HungPham-VNU/game-console/docs/es3n28p/ES3N28P_Size.png

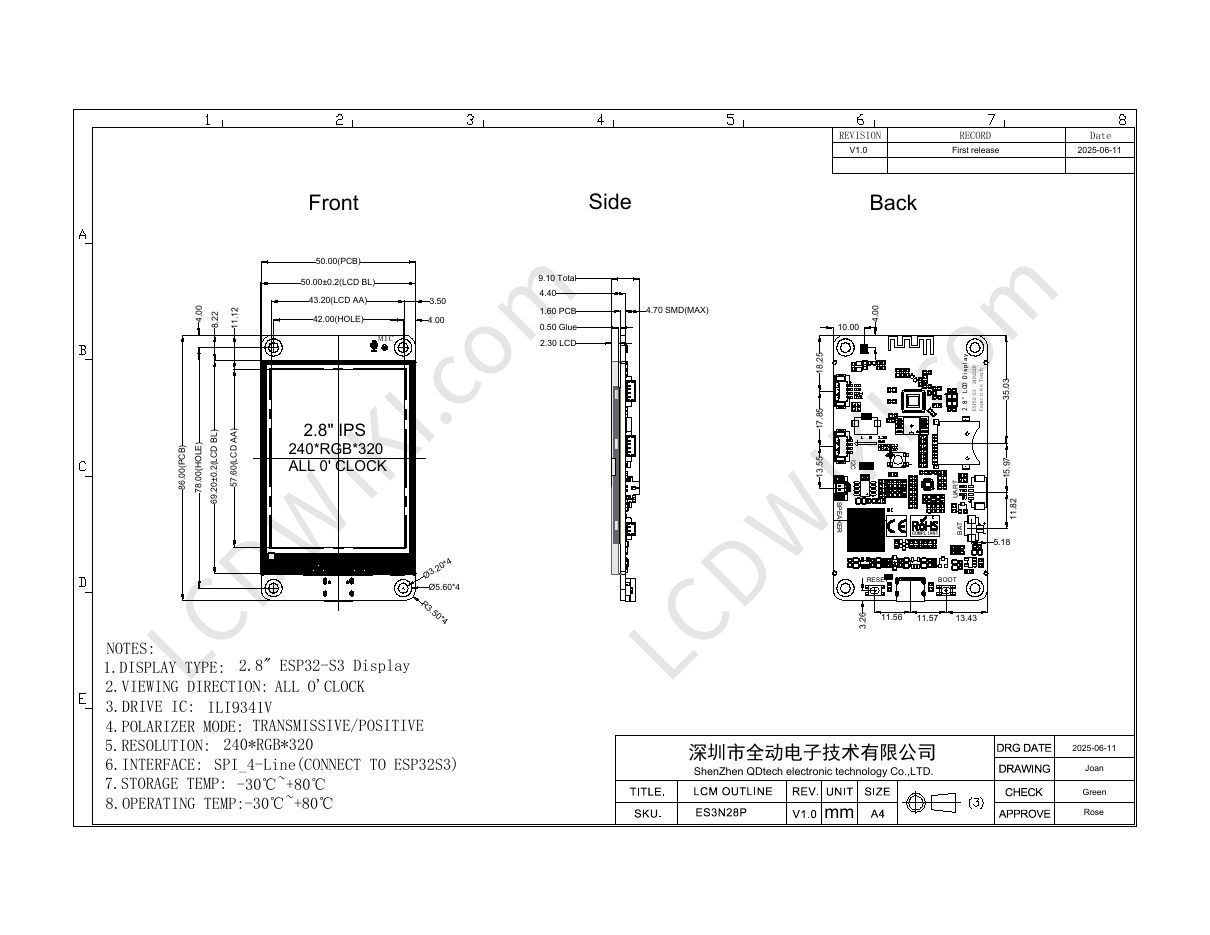
docs/es3n28p/ES3N28P_Size.png
