HungPham-VNU/game-console/enclosure/preview/inside.png

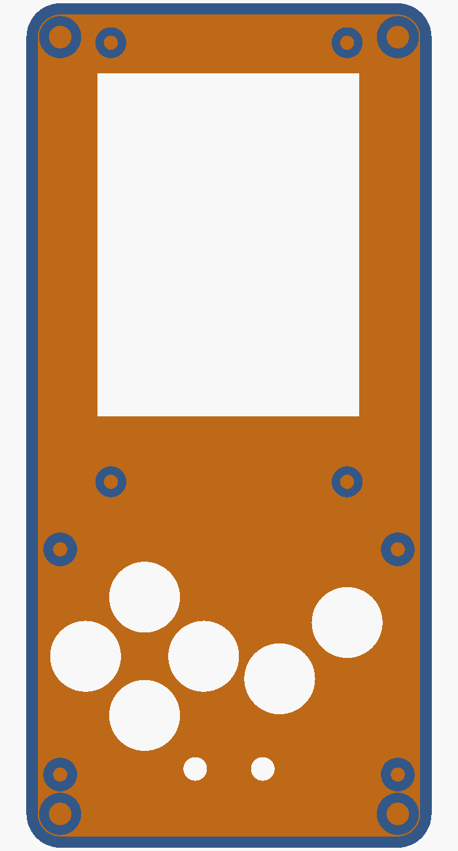
enclosure/preview/inside.png
