HungPham-VNU/game-console/firmware/retro-go-gmt024-s3/assets/retro-go-preview.jpg

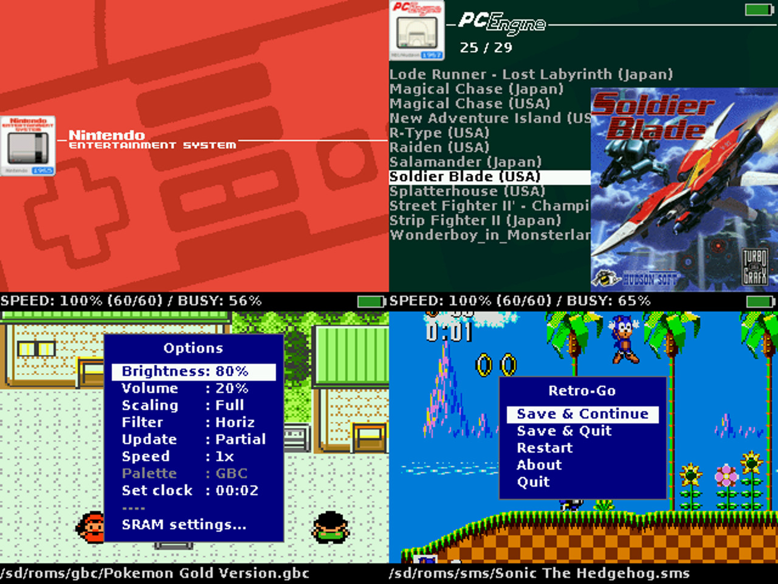
firmware/retro-go-gmt024-s3/assets/retro-go-preview.jpg
