HungPham-VNU/game-console/firmware/retro-go-gmt024-s3/components/retro-go/targets/nullnano/docs/Schematic.png

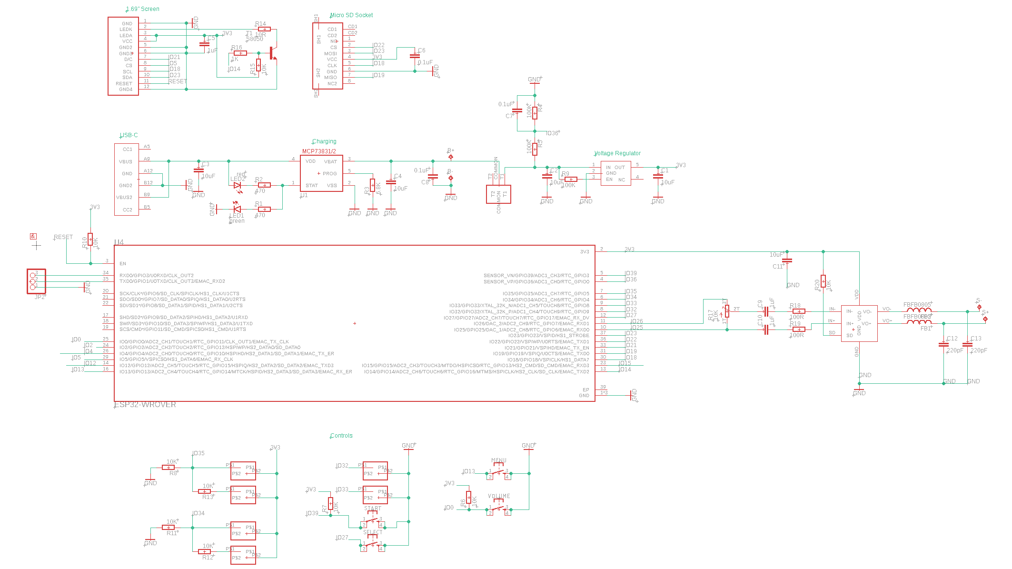
firmware/retro-go-gmt024-s3/components/retro-go/targets/nullnano/docs/Schematic.png
