HungPham-VNU/game-console/firmware/retro-go-gmt024-s3/themes/classic/background.png

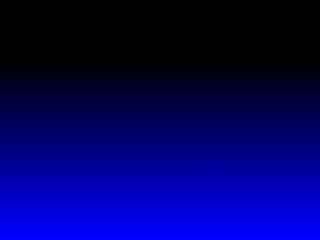
firmware/retro-go-gmt024-s3/themes/classic/background.png
