HungPham-VNU/game-console/firmware/retro-go-gmt024-s3/themes/default/background_gw.png

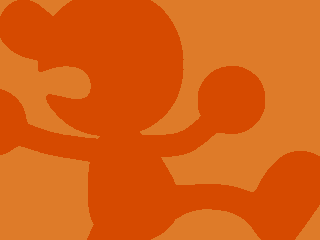
firmware/retro-go-gmt024-s3/themes/default/background_gw.png
