HungPham-VNU/game-console/firmware/retro-go-gmt024-s3/themes/default/background_pce.png

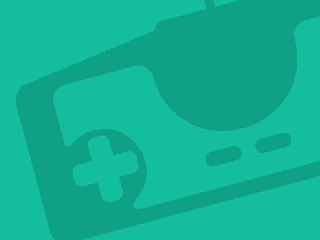
firmware/retro-go-gmt024-s3/themes/default/background_pce.png
