HungPham-VNU/game-console/firmware/retro-go-gmt024-s3/components/retro-go/targets/brutzelboy/docs/front.jpg

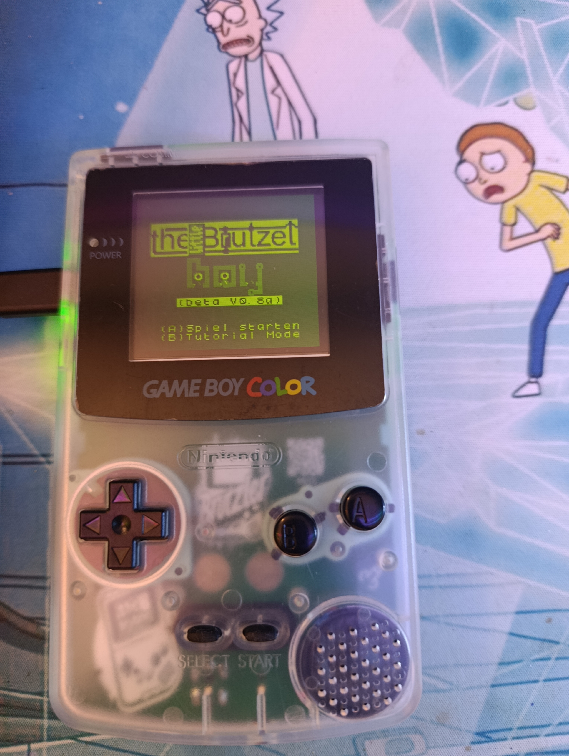
firmware/retro-go-gmt024-s3/components/retro-go/targets/brutzelboy/docs/front.jpg
