HungPham-VNU/game-console/firmware/retro-go-gmt024-s3/components/retro-go/targets/esp32-s3-devkit/docs/device.jpg

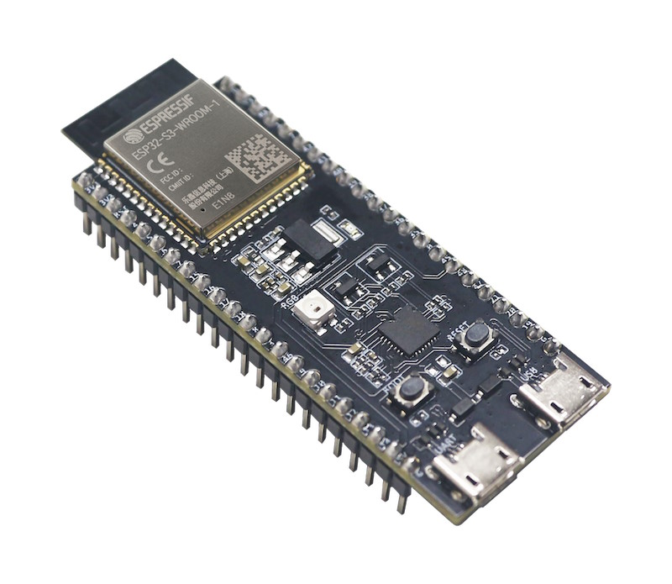
firmware/retro-go-gmt024-s3/components/retro-go/targets/esp32-s3-devkit/docs/device.jpg
