HungPham-VNU/game-console/firmware/retro-go-gmt024-s3/components/retro-go/targets/mrgc-g32/docs/device.jpg

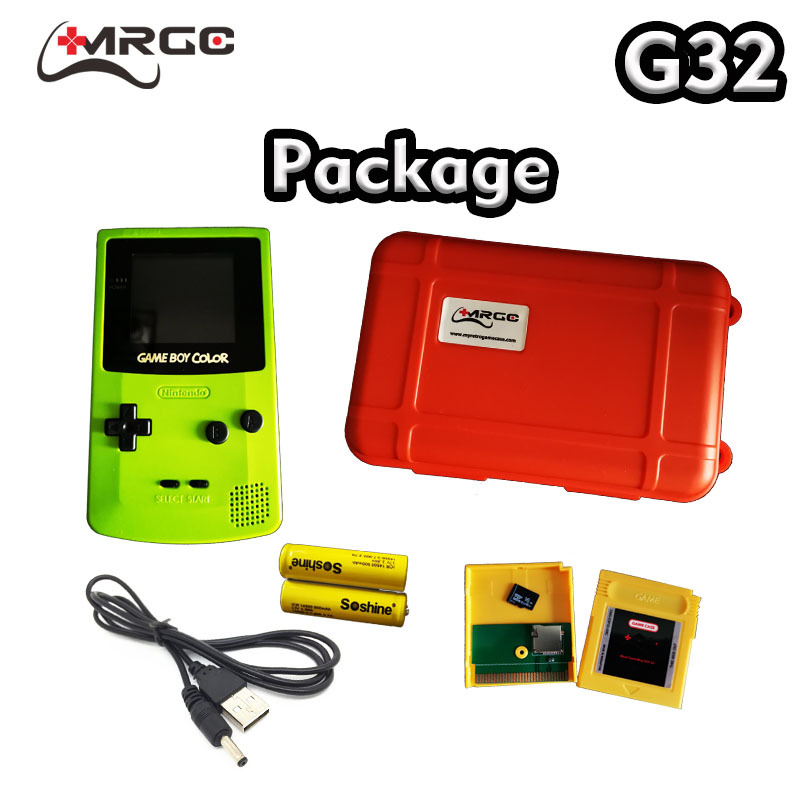
firmware/retro-go-gmt024-s3/components/retro-go/targets/mrgc-g32/docs/device.jpg
