HungPham-VNU/game-console/firmware/retro-go-gmt024-s3/components/retro-go/targets/rachel-esp32/docs/device_top.jpg

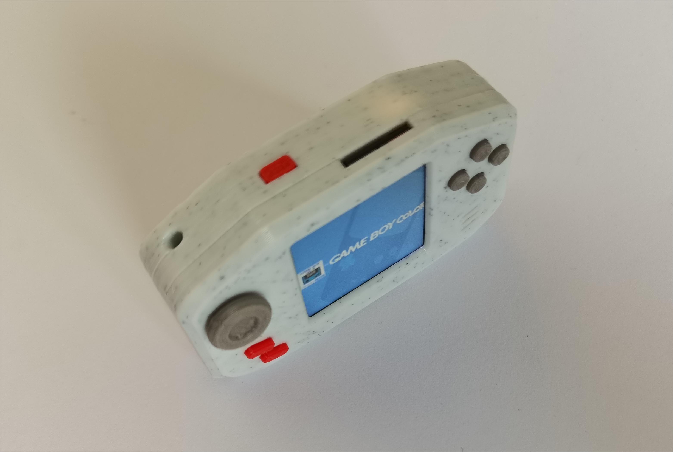
firmware/retro-go-gmt024-s3/components/retro-go/targets/rachel-esp32/docs/device_top.jpg
