HungPham-VNU/game-console/firmware/retro-go-gmt024-s3/components/retro-go/targets/redroid-go/docs/device.png

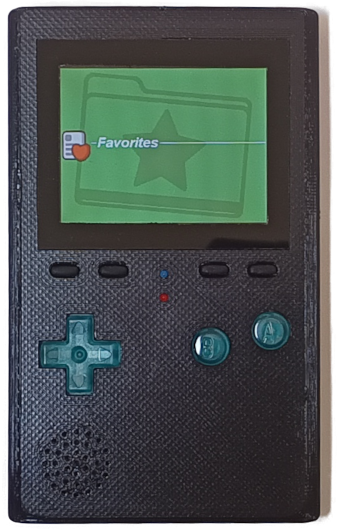
firmware/retro-go-gmt024-s3/components/retro-go/targets/redroid-go/docs/device.png
