HungPham-VNU/game-console/firmware/retro-go-gmt024-s3/components/retro-go/targets/retro-ruler-V1/docs/device.png

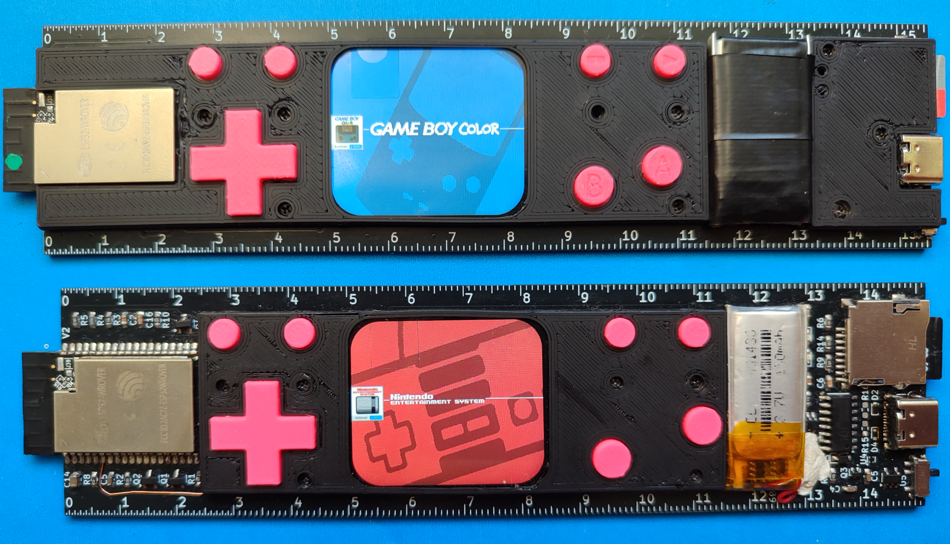
firmware/retro-go-gmt024-s3/components/retro-go/targets/retro-ruler-V1/docs/device.png
