HungPham-VNU/game-console/firmware/retro-go-gmt024-s3/components/retro-go/targets/t-deck-plus/docs/t-deck-plus_key_layout.png

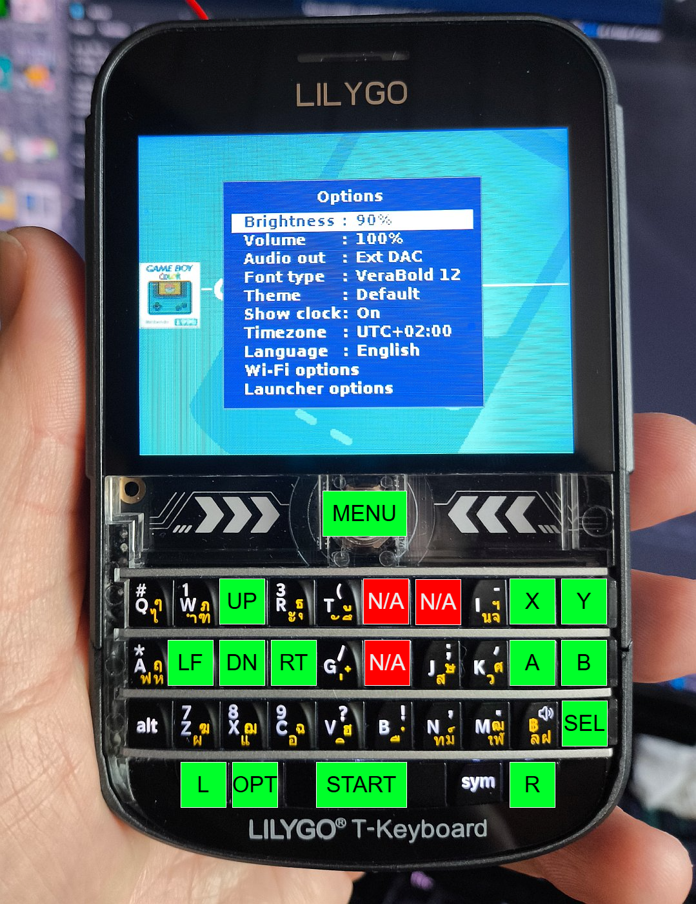
firmware/retro-go-gmt024-s3/components/retro-go/targets/t-deck-plus/docs/t-deck-plus_key_layout.png
