HungPham-VNU/game-console/enclosure/stl/test_front.stl

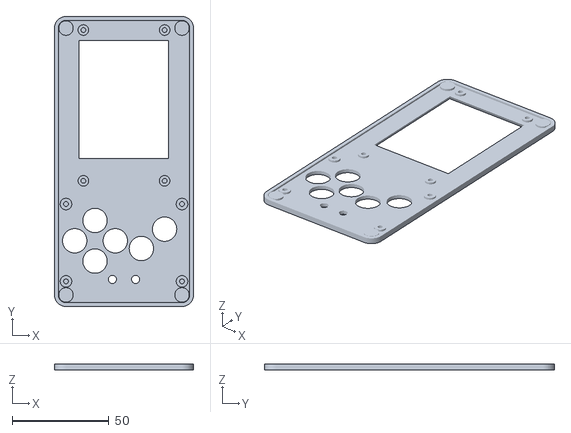
[picture p44: CAD file, 2026-11-06]
enclosure/stl/test_front.stl
72.0 x 150.0 x 3.00
