HungPham-VNU/game-console/enclosure/stl/lid.stl

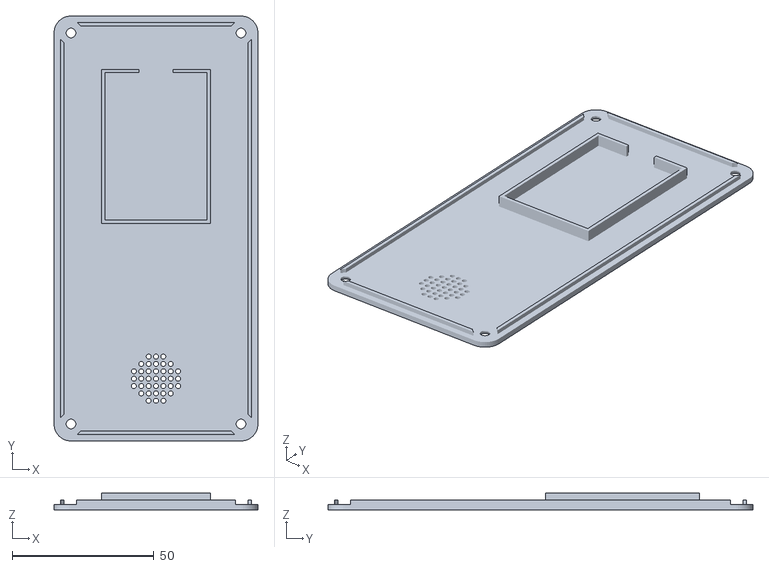
[picture p45: CAD file, 2026-11-06]
enclosure/stl/lid.stl
72.0 x 150.0 x 6.00
