HungPham-VNU/game-console/enclosure/stl/shell.stl

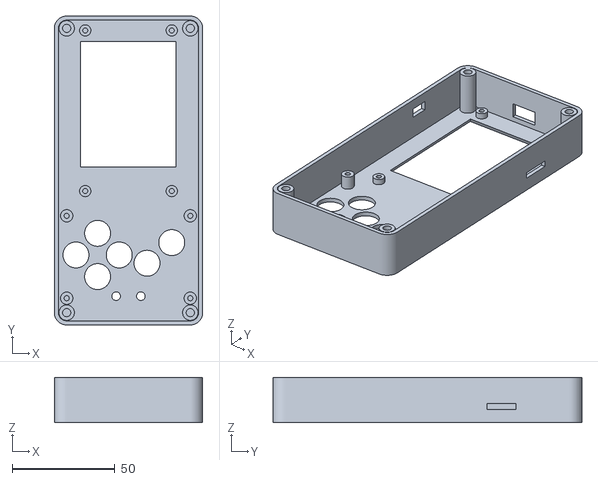
[picture p46: CAD file, 2026-11-06]
enclosure/stl/shell.stl
72.0 x 150.0 x 22.0
