HungPham-VNU/game-console/docs/es3n28p/ES3N28P_Size.pdf

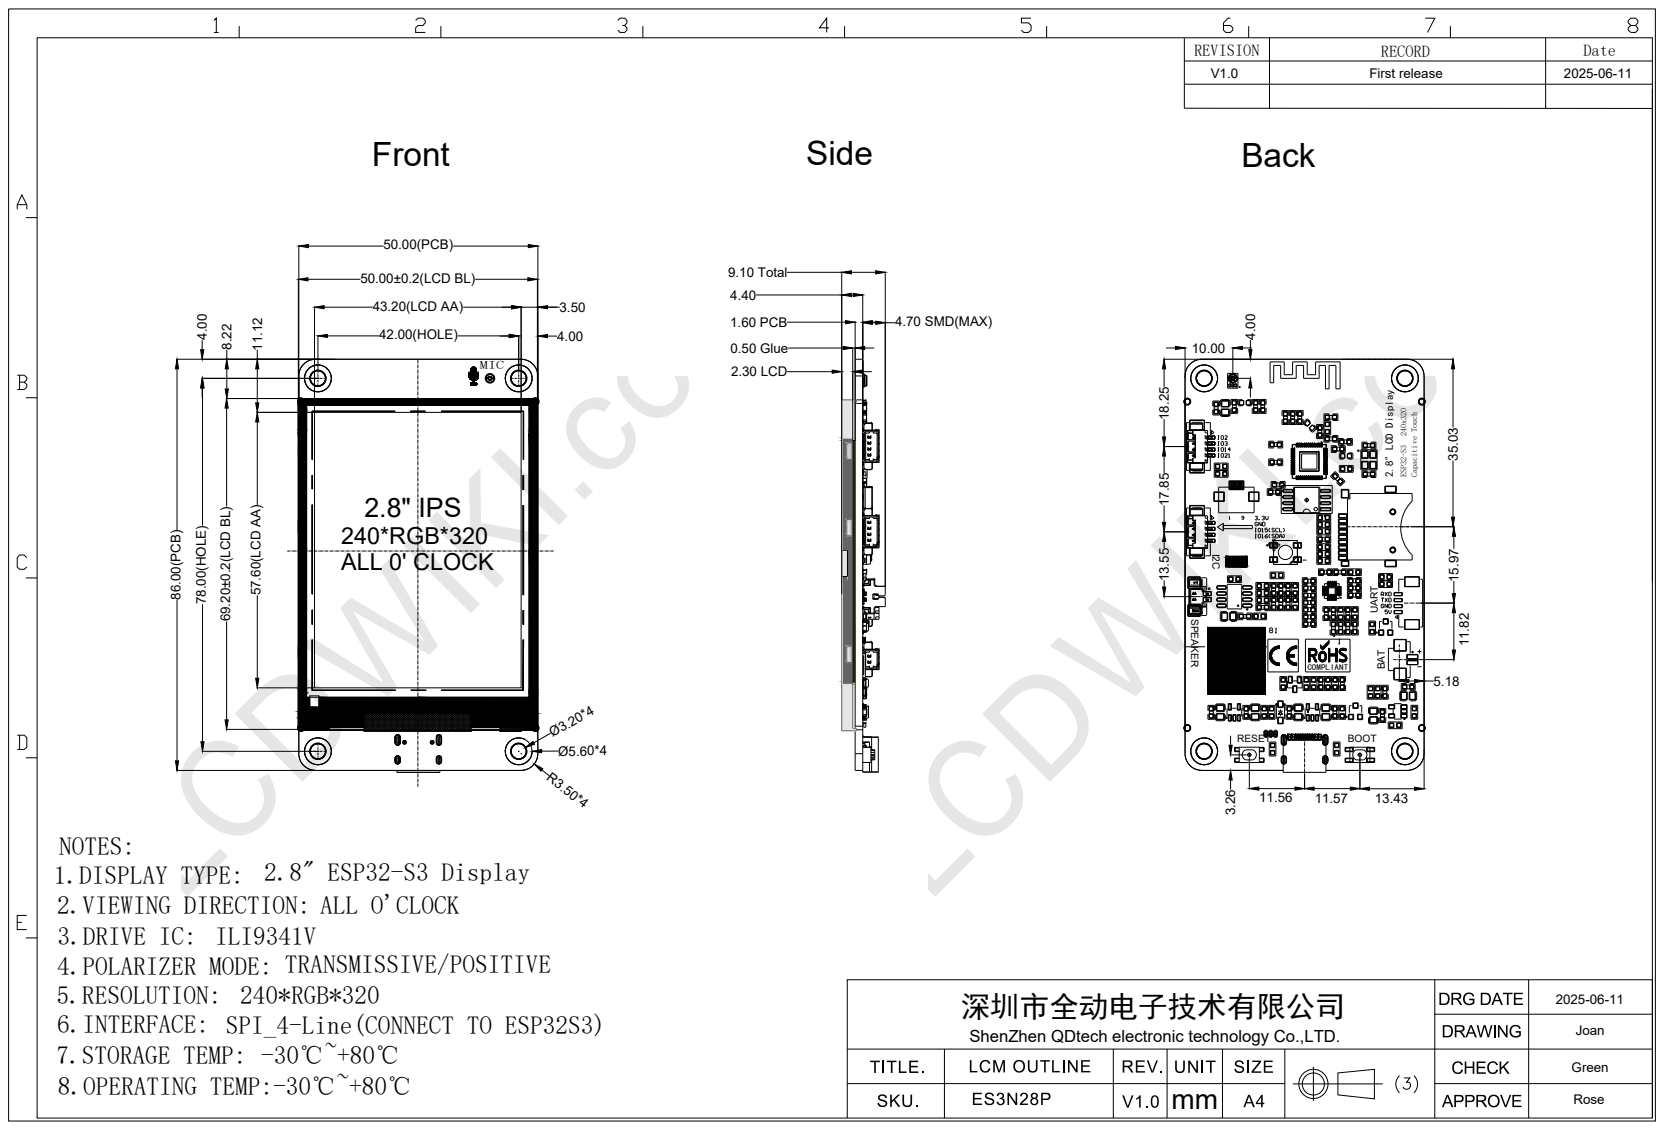
[picture p47: page 1]
SPEAKER COMPLIANT; 2.8" LCD Display; ESP32-S3 240x320; 57.60(LCD AA)

LCDWIKI.com RECORD Date NOTES: 1.DISPLAY TYPE: 2.VIEWING DIRECTION: 3.DRIVE IC: 4.POLARIZER MODE: 5.RESOLUTION: 6.INTERFACE: 7.STORAGE TEMP: 8.OPERATING TEMP:-30℃~+80℃ REVISION mm 深圳市全动电子技术有限公司 ShenZhen QDtech electronic technology Co.,LTD. TITLE. SKU. LCM OUTLINE REV. UNIT SIZE A4 DRG DATE DRAWING CHECK APPROVE V1.0 First release 2025-06-11 2.8" ESP32-S3 Display ALL O'CLOCK TRANSMISSIVE/POSITIVE 240*RGB*320 SPI_4-Line(CONNECT TO ESP32S3) -30℃~+80℃ ILI9341V V1.0 2025-06-11 Joan Green Rose Front Side Back RESET

86.00(PCB) 50.00(PCB) 4.70 SMD(MAX) 35.03

15.97 5.18 43.20(LCD AA) 50.00±0.2(LCD BL)

4.00 10.00 3.50 1.60 PCB 0.50 Glue 2.30 LCD 9.10 Total QDTFT Ø5.60*4 Ø3.20*4 R3.50*4 ES3N28P

Capacitive Touch MIC 42.00(HOLE)

69.20±0.2(LCD BL) 2.8" IPS 240*RGB*320 ALL 0' CLOCK

UART BAT BOOT
