HungPham-VNU/game-console/(commit log)

2026-11-06 feat: add ES3N28P handheld project docs, case CAD, and Retro-Go firmware base
    [case.scad, lid.stl, shell.stl, test_front.stl]
2026-11-08 feat(brick-game): add F1 Brick Game firmware with Tetris
    PlatformIO/Arduino/LovyanGFX firmware for the ES3C28P (ESP32-S3 N16R8):
    platform-free core (Grid, Frame, Game interface, App state machine),
    Tetris (7-bag, wall kicks, line-clear flash, curtain), segment-LCD
    renderer with diffed redraws, PCF8574 input with debounce/auto-repeat
    and BOOT-button fallback, NVS high scores, sound stub.
    Boot prints chip/PSRAM/I2C diagnostics and runs an RGB colour test.
    Builds and flashes via Docker (pio.sh, no host install or dialout
    needed); host unit tests in test_host/ (115 checks pass).
    Verified on hardware: PSRAM 8 MB, flash 16 MB, I2C 0x18 + 0x38.
2026-11-08 feat(brick-game): add on-screen touch buttons for the ES3C28P
    Read the FT6336G (0x38, RST IO18) directly over Wire on the shared I2C
    bus, tracking up to two fingers. When touch is present and no PCF8574
    is wired, switch to a compact layout (10 px cells) with an on-screen
    D-pad, SELECT, START, B and A. Touches are OR-ed into Input before
    debouncing, so they get the same debounce and auto-repeat as hardware
    buttons. The D-pad is a single zone resolved by offset from its centre,
    fixing missed taps between arrows seen on the real board.
    The renderer is now driven by a Layout struct (classic and touch).
    Touch mapping verified on hardware: no axis flip at LCD_ROTATION 2.
    Host tests cover layout g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
    [Input.cpp, Input.h, Touch.cpp, Touch.h, bootlog.py]
2026-11-08 feat(brick-game): add Snake and Racing with a three-game menu
    Snake: D-pad steering with a 2-turn buffer and no reversing, A = 3x
    boost, wall/self collision (tail-following allowed), blinking apple,
    10 x (L+1) per apple, level up every 8 apples, 400 ms x 0.85^L steps.
    Racing: two lanes between scrolling road edges, LEFT/RIGHT change lane,
    A/UP = 2x boost, a car every 10 rows in a random lane, cell-exact
    crash detection, 10 x (L+1) per car passed, level up every 15 cars.
    The menu cycles Tetris / Snake / Racing with per-game high scores.
    Adds a shared decayInterval() helper. Host tests: 296 checks, including
    a bot that survives 3000 ticks of Racing at every speed 0-9.
    [main.cpp]
